MichaelLT38/RobotRover/(commit log)

2026-10-22 Initial commit: RobotRover for the Arduino UNO Q
    Drive a two-wheel robot with a 4-servo arm from an Android phone or a
    desktop browser over Bluetooth LE.
    - RobotRover.ino + RobotMatrix.h: sketch for the UNO Q microcontroller
    (wheels via TB6612FNG, servos via PCA9685, Bridge "robot" method,
    face + icons on the 13x8 LED matrix)
    - board/: Bluetooth LE relay for the UNO Q's Linux side (Nordic UART
    Service -> arduino-router MessagePack-RPC), with offline and standard
    install options
    - android/: Kotlin app with no third-party libraries
    - desktop/: Web Bluetooth controller with keyboard, console, demo mode
    and LED matrix preview
    - RobotRover_System_Guide.pdf, README.md and images/: desig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
    [ic_robot.xml]
2026-11-11 Power, battery gauge, safe power-off and 8BitDo gamepad support
    Moves RobotRover to a one-battery power layout and adds the firmware,
    relay, app and docs changes that go with it.
    Sketch
    - Commands and loop() take turns through a Zephyr mutex: the Bridge
    runs commands on its own thread (measured on the board). Commands
    only set targets; loop() does every pin and I2C write.
    - Servos go to home one at a time at power-on; the wheels ramp up over
    about 150 ms; the open gripper goes limp after 3 s idle.
    - Battery gauge on A0 (20k/10k divider, enabled with BATTERY_SENSE):
    low and empty states with matrix icons; when empty, every move is
    refused. New command: batt.
    - New commands: m L R [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
2026-11-13 Relay and gamepad: share replies, coalesce drive commands, faster recovery
    - The gamepad now sees every sketch reply, whoever sent the command, so
    its arm angles and top speed follow the phone's changes instead of
    jumping the arm back to its own stale values.
    - After a refused move (battery empty, powering off) the gamepad pauses
    its arm steps and re-reads the positions.
    - A newer drive or stop command replaces the same source's queued drive
    commands, so a backlog can't replay stale driving.
    - The allowlist accepts ASCII digits only.
    - At startup the relay resets the microcontroller after 5 s of 'not
    available' instead of always waiting 20 s (boot to ready: 46 s -> 31 s).
    - run.sh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
    [robot_ble_bridge.py, robot_gamepad.py]
2026-11-13 Sketch: poll the Serial Monitor every 50 ms; clearer help text
    Monitor.available() is a round trip to the Linux side, and it ran on
    every loop() pass. Polling every 50 ms leaves the loop free for the
    wheel ramp, servo steps and matrix. The help text now says that
    poweroff typed in the Serial Monitor does not shut Linux down, and
    'tank drive' wording becomes 'wheel speeds'.
2026-11-13 Android: hold-to-drive survives thumb drift, sliders follow the robot
    - A held drive button keeps its touch, so the page can't scroll and stop
    the robot when the thumb drifts.
    - An arrow no longer stays lit after a disconnect during a hold.
    - Stop is only sent when a drive button was held (or Stop is tapped),
    not on every pause.
    - The app asks for positions on connect and moves its sliders from the
    robot's replies, so they match after the gamepad, a refused move or a
    reconnect. The relay sends the phone one pos line after the gamepad
    changes the arm or the speed.
    - High connection priority after connecting, for quicker stops.
    - Version 1.3.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
    [robot_ble_bridge.py]
2026-11-13 Desktop: Cancel really cancels, sliders follow the robot, layout-proof keys
    - Cancel while connecting abandons the attempt and drops the link,
    instead of ending up 'Connected' with no way to disconnect.
    - The page asks for positions on connect and moves its sliders and
    preview model from the robot's replies, so demo values no longer leak
    into a real connection and the gamepad's changes show up.
    - The 'replies aren't available' message is no longer overwritten.
    - Power off stops driving before the confirm dialog.
    - Drive keys use key position (e.code); right-click no longer drives;
    the matrix preview repaints only changed cells.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
2026-11-13 Docs: audit corrections, release 1.3, README GIF
    README and PDF guide corrected against the code: left-stick driving
    (not both sticks), five board files, Power off tested (battery power
    still open), who the relay runs as in each install, the wiring render
    command, poweroff from the Serial Monitor, and leftover tank-drive
    wording. Adds what was missing: commands for the setup.sh install,
    restarting the relay after editing the button map, the reply texts and
    other values that must match across files, and security notes for
    drive time 0 and the gamepad. Documents the 1.3 changes (sliders that
    follow the robot, shared replies, faster boot recovery), aligns the
    install option names, fixes the cov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
    [build_pdf.py]
